paulinabul/rested-restless/media/images/breadboard_setup.jpg

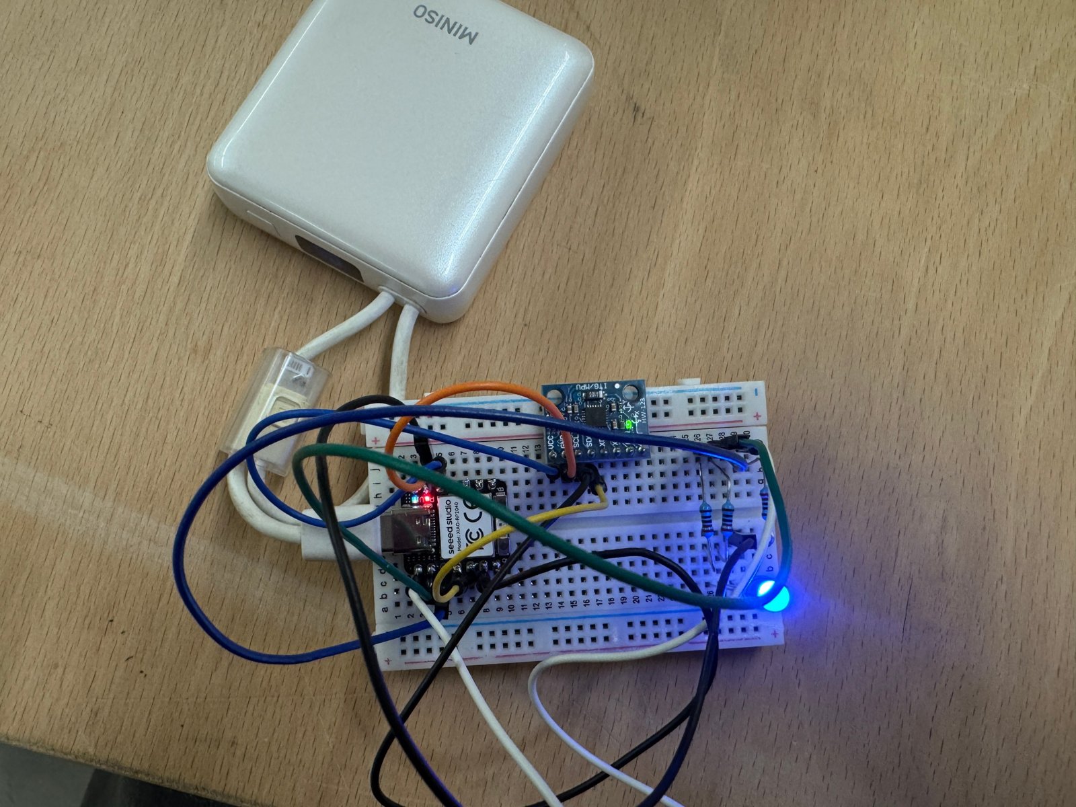
media/images/breadboard_setup.jpg
