paulinabul/rested-restless/media/images/robot_arm_setup.jpg

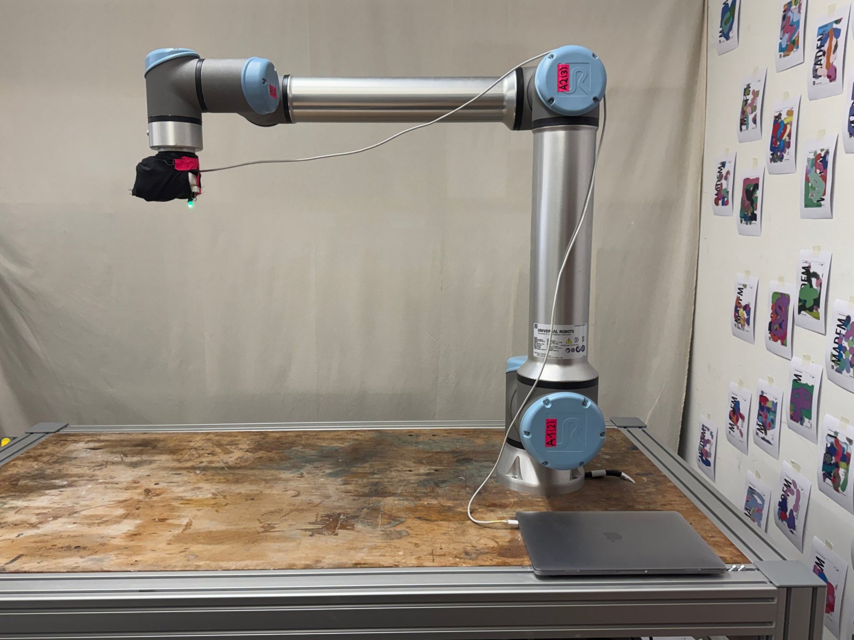
media/images/robot_arm_setup.jpg
