paulinabul/rested-restless/media/images/photo_app_settings.jpg

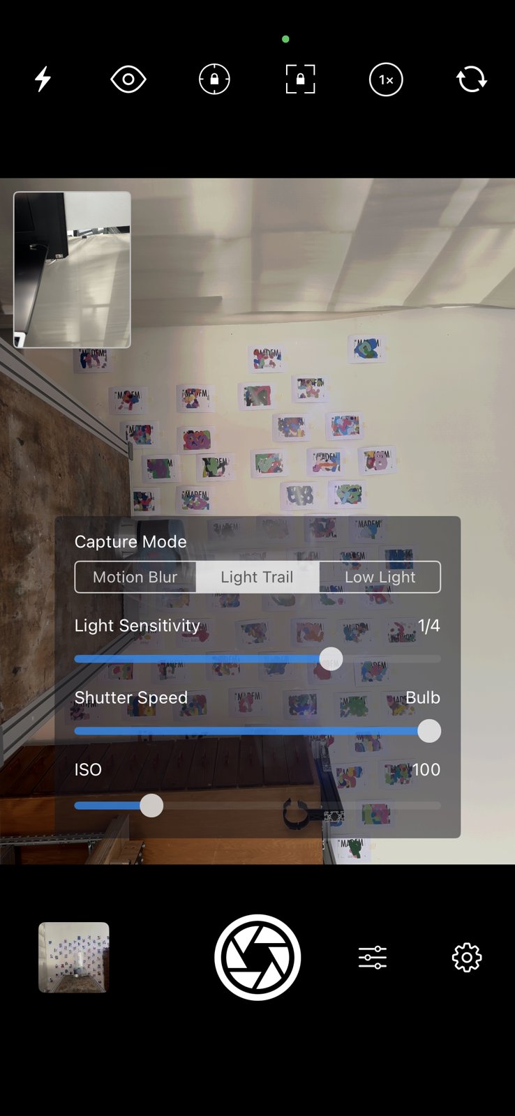
media/images/photo_app_settings.jpg
