paulinabul/rested-restless/media/images/rested_final.jpg

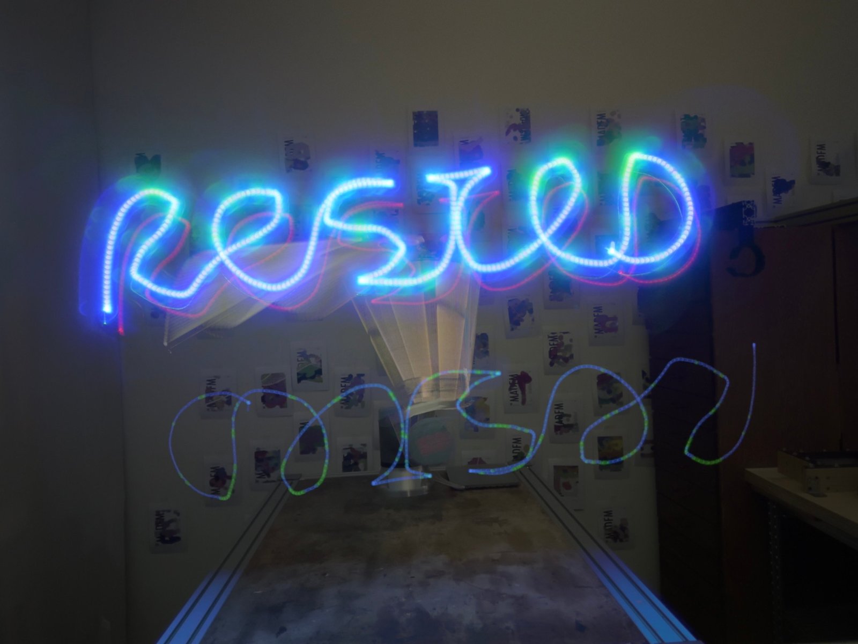
media/images/rested_final.jpg
