paulinabul/rested-restless/media/images/rested_first_try.jpg

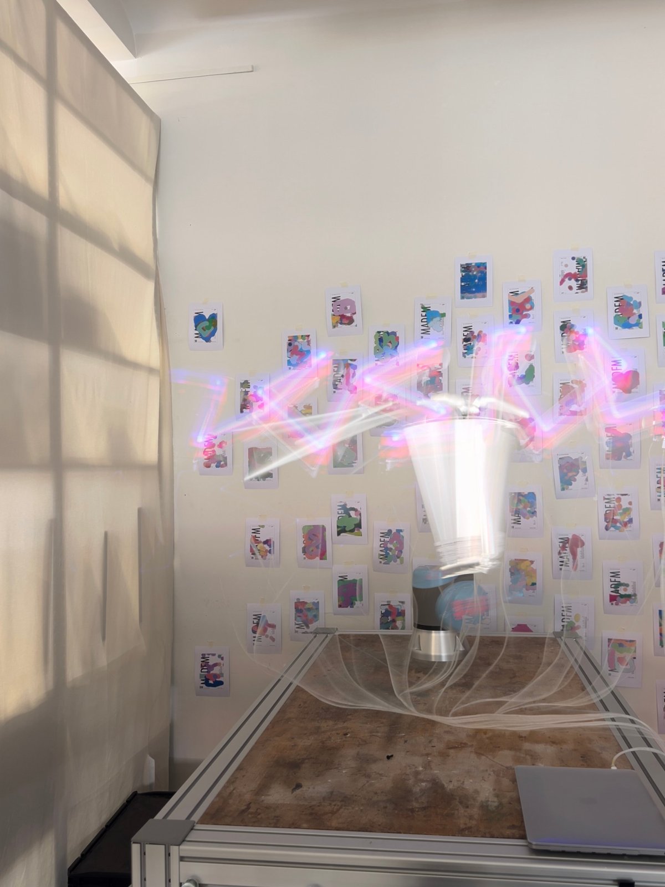
media/images/rested_first_try.jpg
