paulinabul/rested-restless/media/images/restless_final.jpg

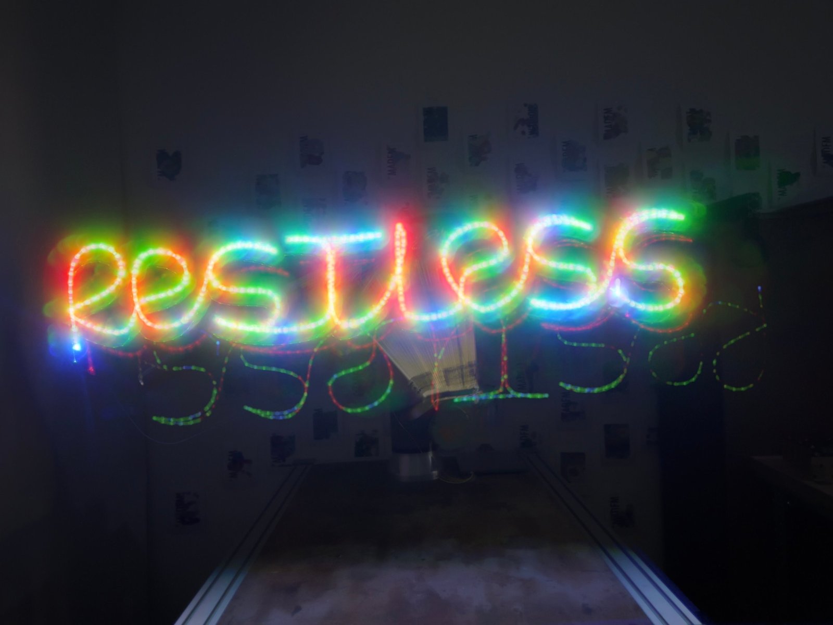
media/images/restless_final.jpg
