paulinabul/rested-restless/(list of files, cad)

Other CAD files:
robot/CreativeCoding_Rested 2.3dm
robot/CreativeCoding_Restless 2.3dm
