paulinabul/rested-restless/diagrams/wiring.png

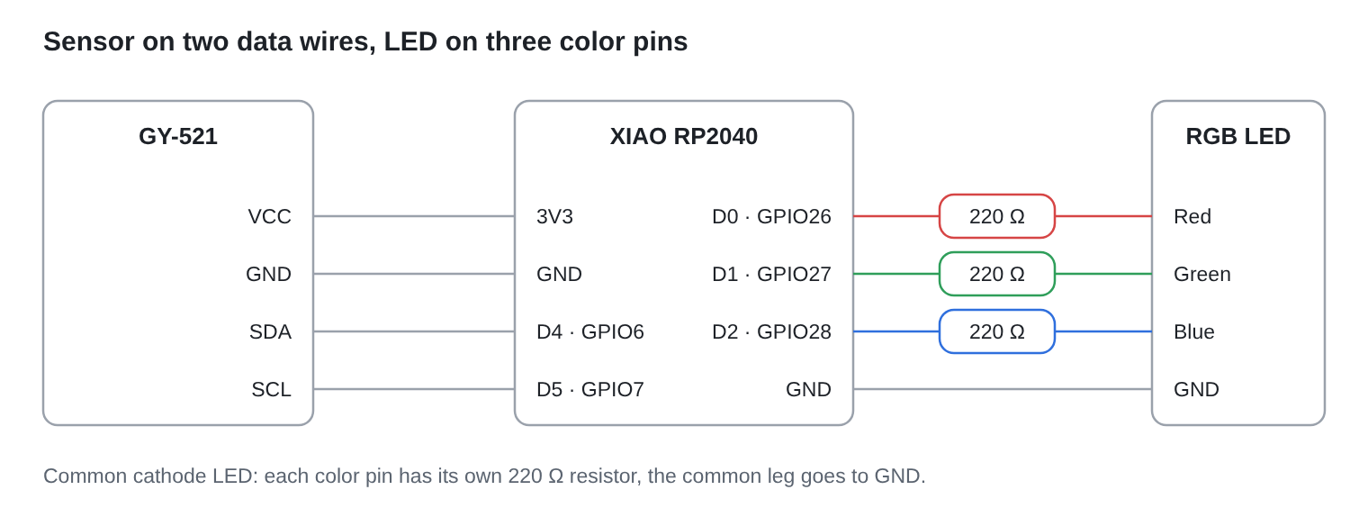
diagrams/wiring.png
