paulinabul/rested-restless/(commit log)

2026-10-27 Read IMU data and calculate magnitude
2026-10-28 Read sensor value from XIAO via pyserial
    Add serial reader script for the laptop: reads the smoothed restlessness
    value line by line from the XIAO, converts it to a float and prints it.
    Add backup of the original course main.py and pySerial source in README.
2026-10-28 Read sensor value from XIAO via pyserial
    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
2026-10-29 Add LED color output driven by restlessness
    Drive an RGB LED from the smoothed restlessness value of the IMU:
    blue = calm, green = medium, red = wild. Runs on the XIAO RP2040
    without a laptop. Includes the earlier steps (magnitude, smoothing,
    upper limit) and the serial reader for the laptop.
2026-11-02 Clean up project structure
    [CreativeCoding_Rested 2.3dm, CreativeCoding_Restless 2.3dm]
